diaverde/termiot/Tecnoparque/higro.jpg

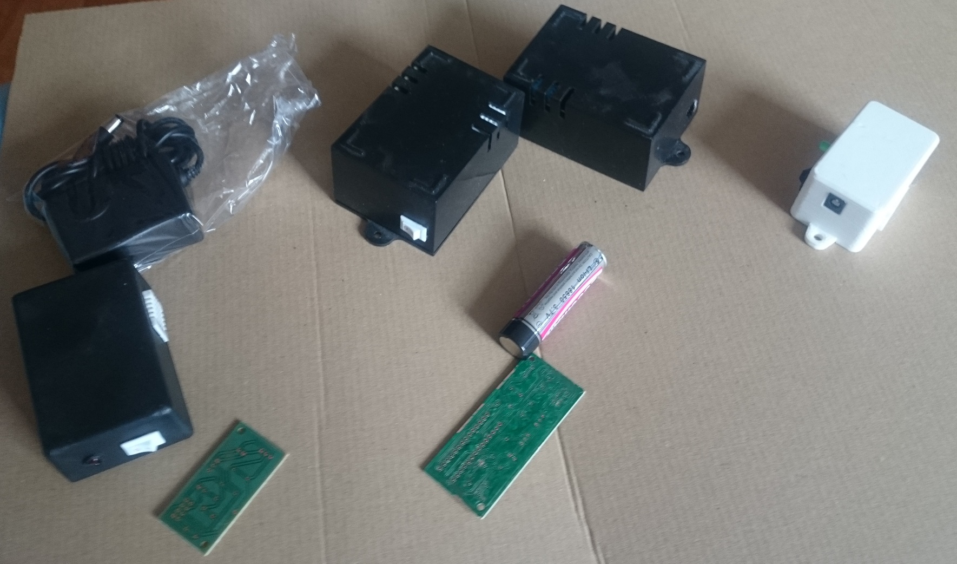
Tecnoparque/higro.jpg
