diaverde/termiot/Tecnoparque/1-Intro.jpg

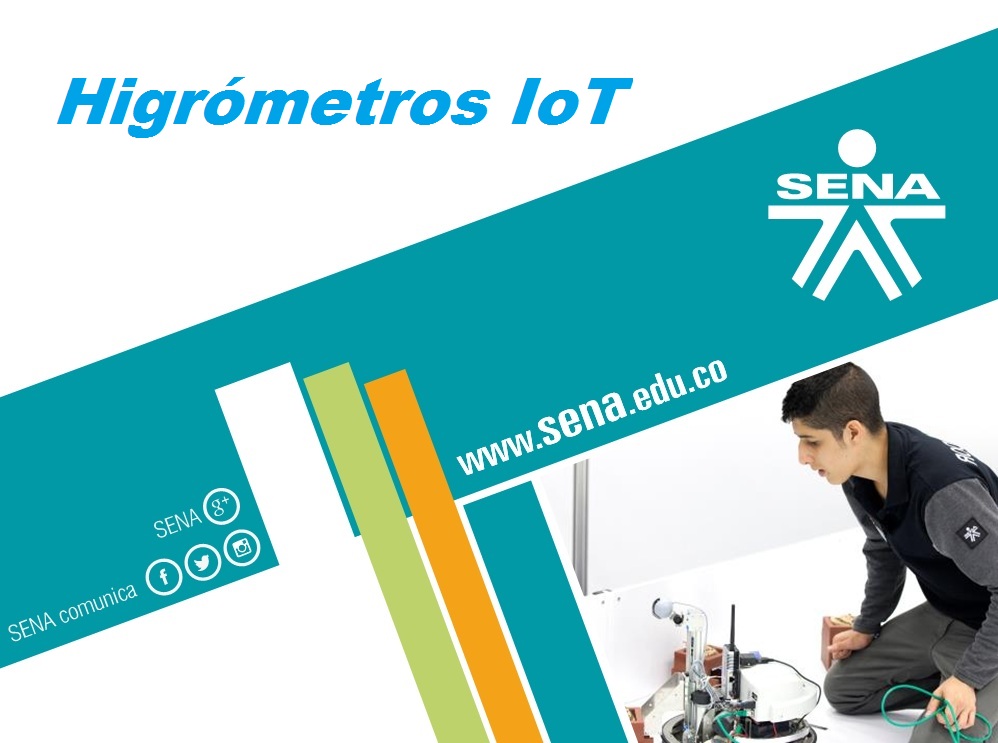
Tecnoparque/1-Intro.jpg
