diaverde/termiot/Tecnoparque/Presentación Comité IBT(Proyecto ####).pptx

Higrómetros IoT

Fecha de la presentación: 13/03/2019

## Slide 2

Identificación, nombres y correos de los integrantes

1. Gustavo Morales, CC 80312654, gustavoalejandrom@gmail.com
2. Andrés Sánchez, CC 80880316, diaverde77@gmail.com

Los que proponemos la idea somos

## Slide 3

Describa en palabras su sueño

Queremos construir un dispositivo de medición de humedad y temperatura que envíe sus datos automáticamente a internet para supervisión remota por parte del usuario final.

Nuestra idea consiste en

## Slide 4

Imágenes del sueño

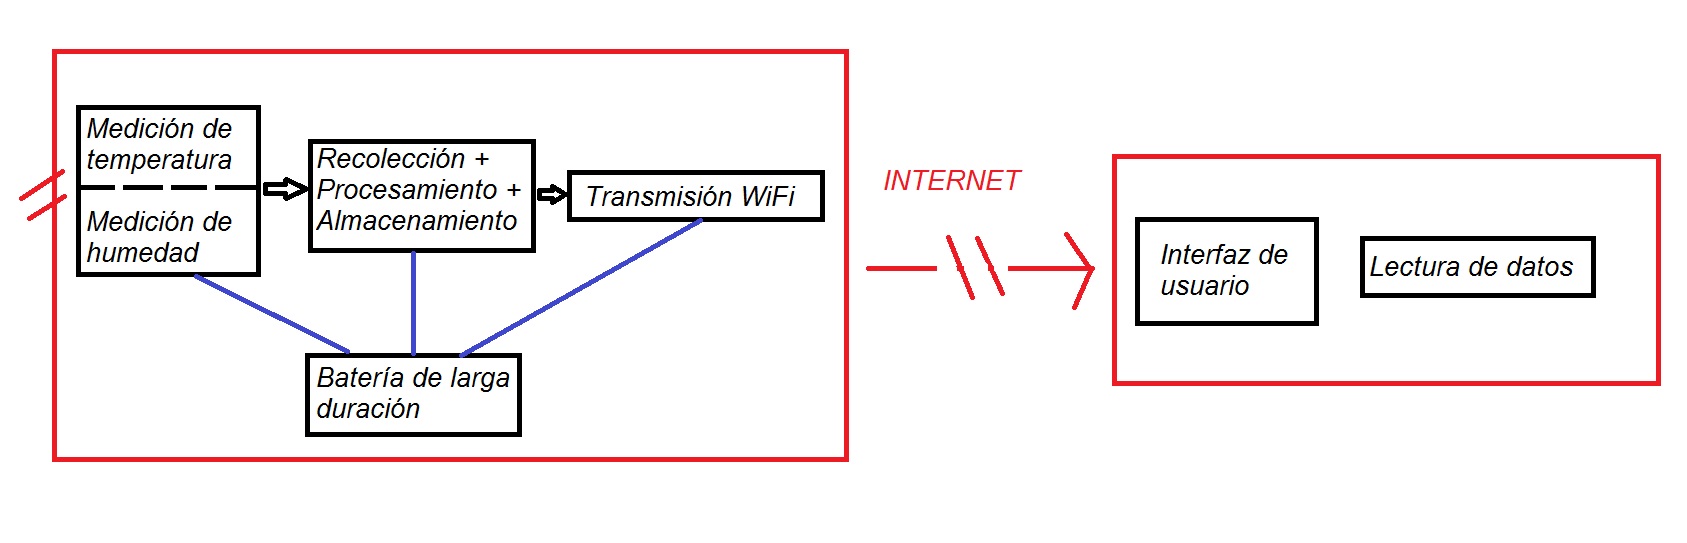
[picture p5: figure]

Imágenes que detallan la idea y sus partes

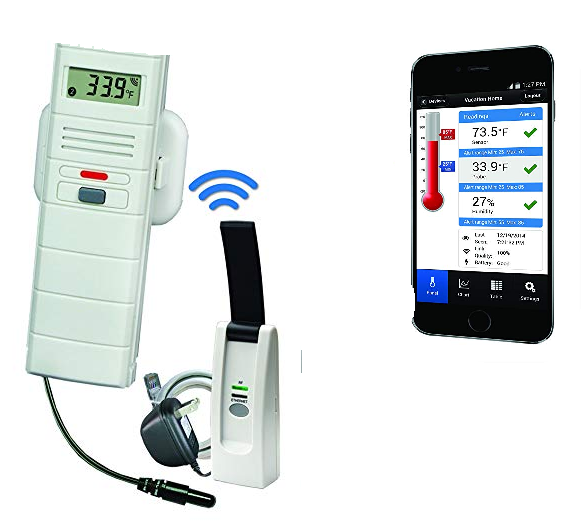
[picture p6: figure]

## Slide 5

Imagen de la idea innovadora

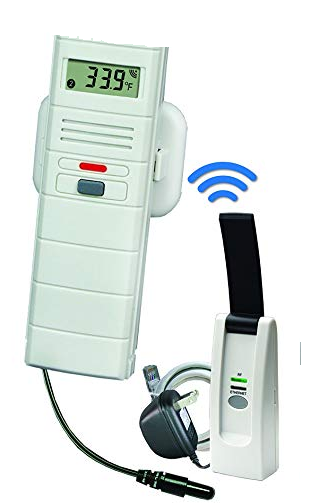
[picture p7: figure]
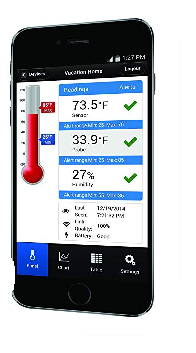
[picture p8: figure]

Descripción: Se presenta un esquemático con los bloques internos que conforman nuestro dispositivo: fase de medición, de procesamiento y de transmisión, con su respectiva alimentación, así como el desarrollo de una interfaz de usuario para la visualización de los datos en internet.

## Slide 6

Tenemos para desarrollar el proyecto

1 . Plataformas de desarrollo de hardware abierto: Arduino, ESP8266.
2. Materiales e instrumentos de electrónica básica (resistencias, leds, condensadores, cautín, estaño, protoboards)
3. Conocimiento en desarrollo de hardware.
4. Conocimiento en desarrollo de aplicaciones web.

¿Con qué contamos?

## Slide 7

Valor de la nueva idea

La idea se diferencia de las existentes en que:
- Contrario a las que se usan actualmente en el país, es una opción hecha en Colombia, con asistencia y soporte local.
- Es integral, incluye la medición, la transmisión de datos y la interfaz de usuario.
- Es de bajo costo comparado con otras alternativas.

¿Qué hace a mi idea diferente y mejor?

## Slide 8

Cifras, nombres, referencias de las búsquedas realizadas

He encontrado que en el mundo hay alternativas, similares, pero en otros países, como:
1. La Crosse Alerts Mobile 926-25101-GP Wireless Monitor System Set with Dry Probe – Una sonda con comunicación WiFi y aplicación Web para teléfono móvil. Disponible en Estados Unidos.
2. SensorPush Wireless Thermometer/Hygrometer for iPhone/Android - Humidity & Temperature Smart Sensor with Alerts – Similar a la anterior.
3. Sonoff Th16 Wifi Temperatura Y Humedad Sensor Interruptor - Un ejemplo que se consigue en Colombia, pero a un precio elevado.

¿Qué hay similar o compite con mi idea?

## Slide 9

Nuestro modelo de negocio consiste en

1. Desarrollo del prototipo inicial para evaluación de factibilidad técnica y de costos asociados.
2. Ofrecimiento de la solución a empresas en pequeñas cantidades inicialmente para evaluar rendimiento.
3. Con base en lo anterior, masificar difusión del producto por voz-a-voz e internet.

¿Cómo sacar provecho económico de la idea?

## Slide 10

Tecnoparque me puede apoyar con

1. Asistencia en la fabricación de PCB prototipo.
2. Posible asistencia en la fabricación de caja para el producto
3. Asistencia técnica general.

¿Qué necesitamos de Tecnoparque?
