diaverde/termiot/Tecnoparque/2-concepto.png

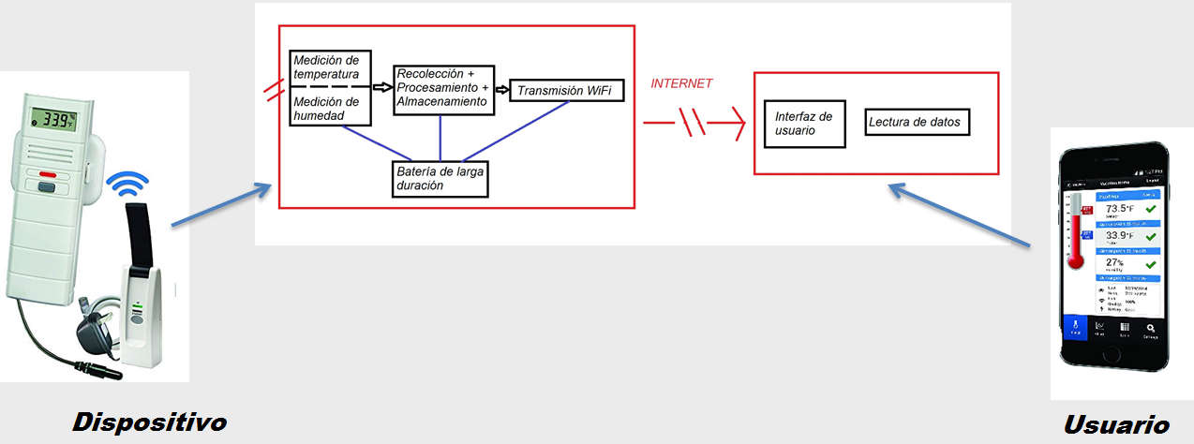
Tecnoparque/2-concepto.png
