diaverde/termiot/Tecnoparque/4-arduino.png

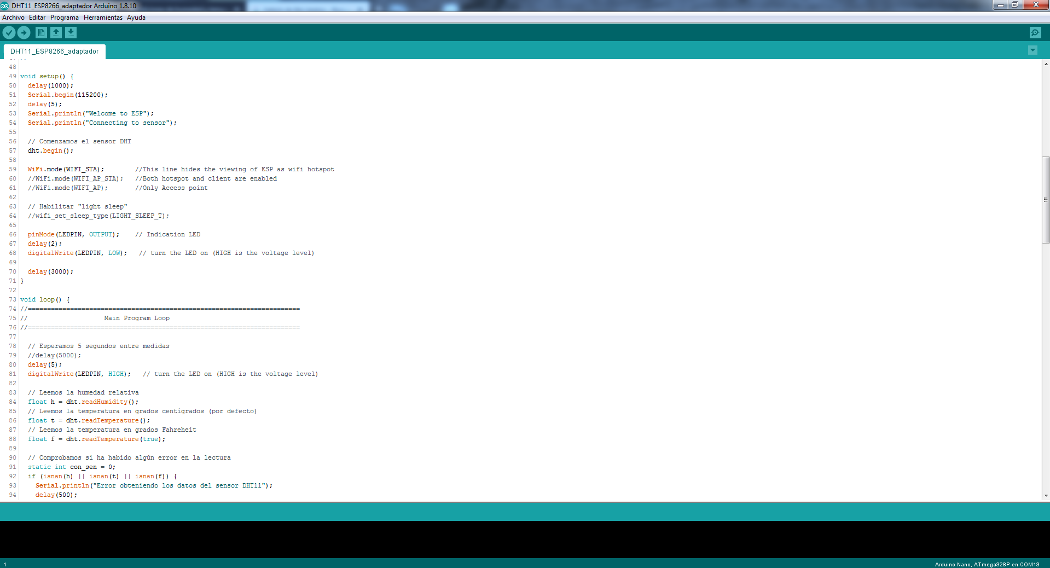
Tecnoparque/4-arduino.png
