diaverde/termiot/Tecnoparque/5-sch.png

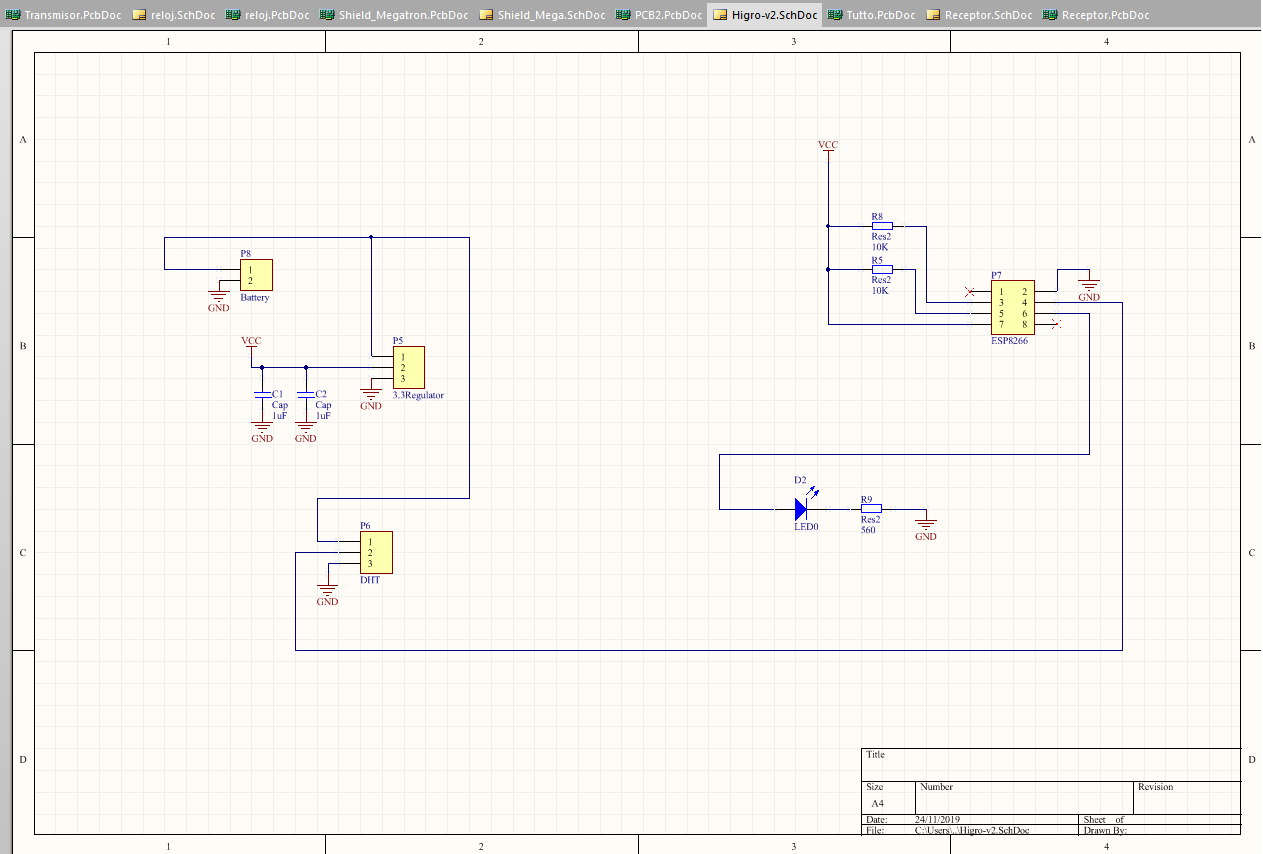
Tecnoparque/5-sch.png
