diaverde/termiot/Tecnoparque/6-pcb.png

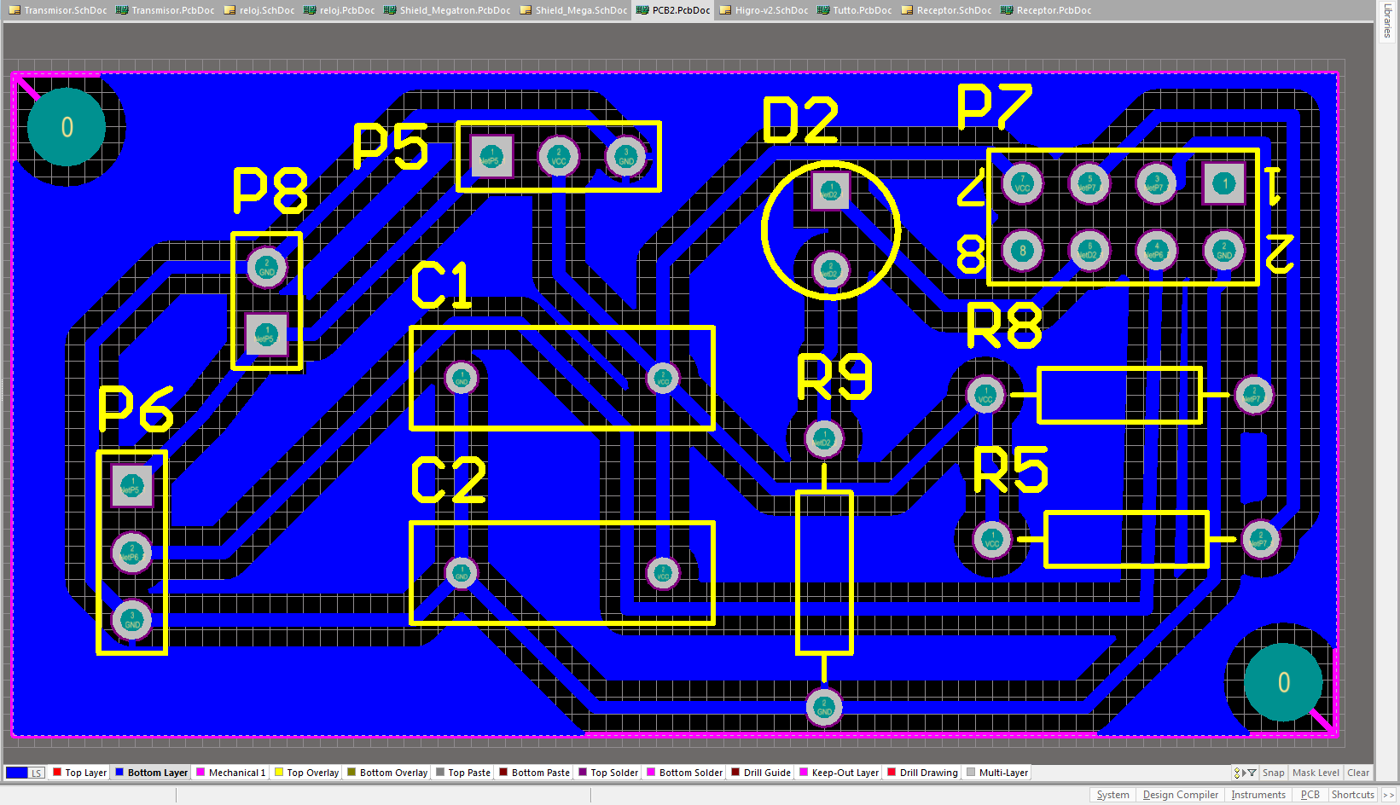
Tecnoparque/6-pcb.png
