diaverde/termiot/Materiales_Higro.xlsx

Sheet: Presupuesto
Con pila
Elemento | Precio unitario estimado | Cantidad | Costo total | Notas | ¿Dónde conseguir?
ESP8266 | 9000 | 1 | 9000 | Sitio recomendado en Bogotá, vienen sin LED de encendido | http://tdrobotica.co/modulo-wifi-esp8266/350.html
Sensor DHT22 | 18000 | 1 | 18000 | ¿Algunos con DHT11? Si se compra sin PCB, se necesitan unas resistencias extra. | https://articulo.mercadolibre.com.co/MCO-451607734-sensor-de-humedad-dht22-arduino-raspberry-_JM?quantity=1
Regulador 3.3V | 2000 | 1 | 2000 | En Medellín. | https://www.didacticaselectronicas.com/index.php/semiconductores/reguladores/reguladores-33v/regulador-de-voltaje-3-3v-250ma-mcp1700-3302e-to-detail
 |  |  |  | Hay opciones en Bogotá pero son SMD. | https://electronilab.co/tienda/mcp1825s-3302edb-regulador-smd-de-3-3-v/
 |  |  |  | Opción en Bogotá no SMD, pero hay que probar si da la corriente | https://www.sigmaelectronica.net/producto/lp2950cza-3-3/
Condensadores | 100 | 2 | 200 | De 100 uF electrolítico y 0,1 uF cerámico
Resistencias | 100 | 6 | 600 | Todas de 10k menos una de 560 ohm para el led
Micro ATMega 328 | 9000 | 1 | 9000 |  | https://articulo.mercadolibre.com.co/MCO-461624276-microcontrolador-atmega328p-sin-bootloader-_JM?quantity=1
Led | 300 | 1 | 300
Batería Li-ion | 25000 | 1 | 25000
Portapila | 4000 | 1 | 4000
Headers | 1000 | 1 | 1000 | 2x4 H, 1x3 M
Baquela | 2000 | 1 | 2000 | Universal perforada
Caja | 25000 | 1 | 25000
 |  | TOTAL | 96100
Con adaptador
Elemento | Precio unitario estimado | Cantidad | Costo total | Notas | ¿Dónde conseguir?
ESP8266 | 10000 | 1 | 10000 | Sitio recomendado en Bogotá, vienen sin LED de encendido | http://tdrobotica.co/modulo-wifi-esp8266/350.html
Sensor DHT22 | 18000 | 1 | 18000 | ¿Algunos con DHT11? Si se compra sin PCB, se necesitan unas resistencias extra. | https://articulo.mercadolibre.com.co/MCO-451607734-sensor-de-humedad-dht22-arduino-raspberry-_JM?quantity=1
Regulador 3.3V | 1500 | 1 | 1500 | En Medellín. | https://www.didacticaselectronicas.com/index.php/semiconductores/reguladores/reguladores-33v/regulador-de-voltaje-33v-08a-low-drop-ldo-encap-reguladores-3-3v-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
 |  |  |  | Regulador actualizado Bogotá (1500) | https://www.sigmaelectronica.net/producto/lm1117dt-3-3/
Condensadores | 100 | 2 | 200 | De 100 uF electrolítico y 0,1 uF cerámico
Resistencias | 100 | 3 | 300 | Todas de 10k menos una de 560 ohm para el led
Led | 300 | 1 | 300
Adaptador 5V | 5000 | 1 | 5000 | 1 amperio | https://articulo.mercadolibre.com.co/MCO-531476423-fuente-adaptador-de-corriente-5-voltios-1-amperio-5v-1a-_JM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
Headers | 1000 | 1 | 1000 | 2x4 H, 1x3 M
Jack de alimentación | 1000 | 1 | 1000
Interruptor | 1000 | 1 | 1000
PCB | 2000 | 1 | 2000 | 8 x 12000
Caja | 15000 | 1 | 15000
 |  | TOTAL | 55300
Opción caja 3D
0,3 mm, 25%
 | Masa (g) | Longitud (m) | Costo
Tapa | 21 | 7.13 | 1920
Base | 7 | 2.51 | 680
TOTAL | 28 | 9.64 | 2600

Sheet: Gastos actuales
Elemento | Precio unitario estimado |  | Andrés |  | Gustavo
ESP8266 | 8000 |  | 4 | 32000 |  | 0
ESP8266-12 | 15000 |  | 1 | 15000 |  | 0
Sensor DHT11 | 7000 |  | 1 | 7000 |  | 0
Sensor DHT22 | 18000 |  |  | 0 |  | 0
Regulador 3.3V | 3000 |  | 1 | 3000 |  | 0
Condensadores | 100 |  |  | 0 |  | 0
Resistencias | 100 |  |  | 0 |  | 0
Micro ATMega 328 | 9000 |  | 1 | 9000 |  | 0
Led | 300 |  |  | 0 |  | 0
 |  |  |  | 0 |  | 0
Batería Li-ion | 25000 |  |  | 0 | 1 | 25000
Portapila | 4000 |  | 1 | 4000 | 1 | 4000
Baquela | 2000 |  |  | 0 |  | 0
 |  |  |  | 0 |  | 0
Caja | 25000 |  |  | 0 |  | 0
 |  | TOTAL |  | 70000 |  | 29000
