diaverde/termiot/Tecnoparque/3-materiales.png

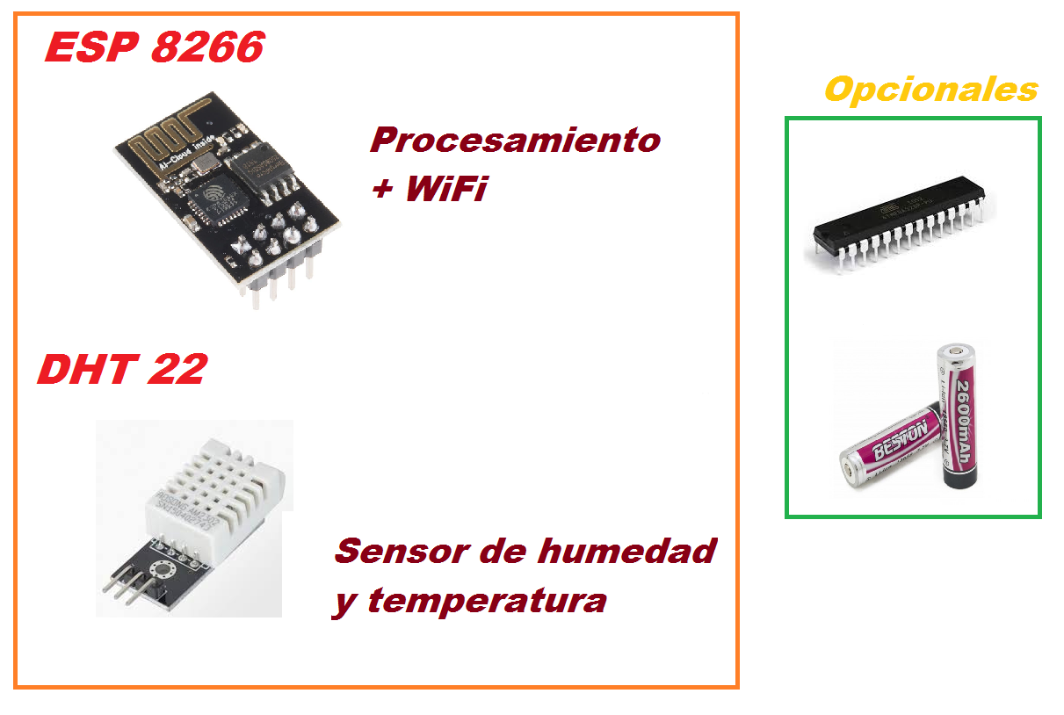
Tecnoparque/3-materiales.png
