diaverde/termiot/(list of files, drawings)

Other design files:
Higro/Higro.PrjPcb
Higro/HigroIoT.SchDoc
