diaverde/termiot/(commit log)

2021-03-06 Carga inicial
    [Higro.PrjPcb, HigroIoT.SchDoc, Materiales_Higro.xlsx, Status.xlsx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]
2021-03-09 Quitar info de baterías
2021-03-09 Quitar sensores no usados
2021-04-22 Se incluye servicio para arranque automático
2021-04-22 Corregidas rutas en el servidor web
2021-04-22 Corregidas rutas en el servidor web (2)
2021-04-25 Incluidos datos en el repositori
    [data1.csv, data2.csv, data3.csv, data4.csv, data5.csv]
2021-04-25 Limpieza de archivos
2021-04-26 Más depuración de código
2021-11-13 Reorganización
    [data10.csv, data4.csv, data6.csv, data8.csv, data9.csv, datatest.csv]
2023-04-16 Updated print statements
